znac049/XEKeyboard/Kicad/XEKeyboard.sch

## KiCad design Kicad/XEKeyboard.sch (2018-02-11, an earlier design)

Schematic: XEKeyboard.sch

Parts:
C1, C3, C9, C10: 0.1uF
C2, C4: 18pF
C5, C6: 22pF
C7, C8: 10uF
J1: USB
J2: POWER
J3: RESET
J4: ICSP
J5: SERIAL
J6: MOBO
JP1: DTR
R1, R2: 33R
R3: 10K
U1: ATMEGA328-AU; TQFP32
U2: max3421e
U3: AMS1117
U4: POKEY
U5, U6: 74LVC125
U7: POKEY_SOCKET
Y1: 12MHz
Y2: 16MHz
