znac049/XEKeyboard/(commit log)

2018-02-01 Created minimal README and dropped current sketch in.
2018-02-02 Fixed typo in filename
    [XEKeyboard.ino]
2018-02-03 - Removed dependence on 3rd party pin change interrupt library. - Fixed a few mapping errors in the PS2 keytable
    [XEKeyboard.ino]
2018-02-05 tarting to look at USB option.
    [XEKeyboard.kicad_pcb, XEKeyboard.sch]
2018-02-07 Getting the schematic down.
    [XEKeyboard.kicad_pcb, XEKeyboard.sch]
2018-02-07 Shcematic passes ERC
    [XEKeyboard.sch]
2018-02-08 Preparing to merge with usbmaster
    [XEKeyboard.kicad_pcb, XEKeyboard.sch]
2018-02-11 - Arduino pin changes to avoid clashes with USB host board - Fixed handling of Ctrl and Shift keys - Created an Out of Band handler for Alt-xx keys
    [XEKeyboard.sch]
2018-02-11 Created Kicad parts library for the special parts used by the project.
